Phong-Phan-24404/FPGA.ECG_SYSTEM/README.md

# ECG 1D-CNN Accelerator | KV260 Engineering Deliverables

**Scope:** Synthesizable streaming ECG classifier, bit-true reference models, design verification, routed FPGA implementation, and KV260 host integration.

| Design item | Released configuration |
| :--- | :--- |
| Device / tool | Kria KV260 (`xck26-sfvc784-2LV-c`) / Vivado 2024.2 |
| Custom IP | `xilinx.com:user:CNN_wrapper:3.0` |
| Datapath | 187 input samples → six Conv1D layers → three FC layers → five logits |
| Numeric format | Q8.8 ; Q2.14; 40-bit Q18.22 accumulator |
| Control / data | AXI4-Lite / AXI4-Stream; PS DDR via AXI DMA |
| Clocking | Single 100 MHz PL clock domain |

## Demo
  
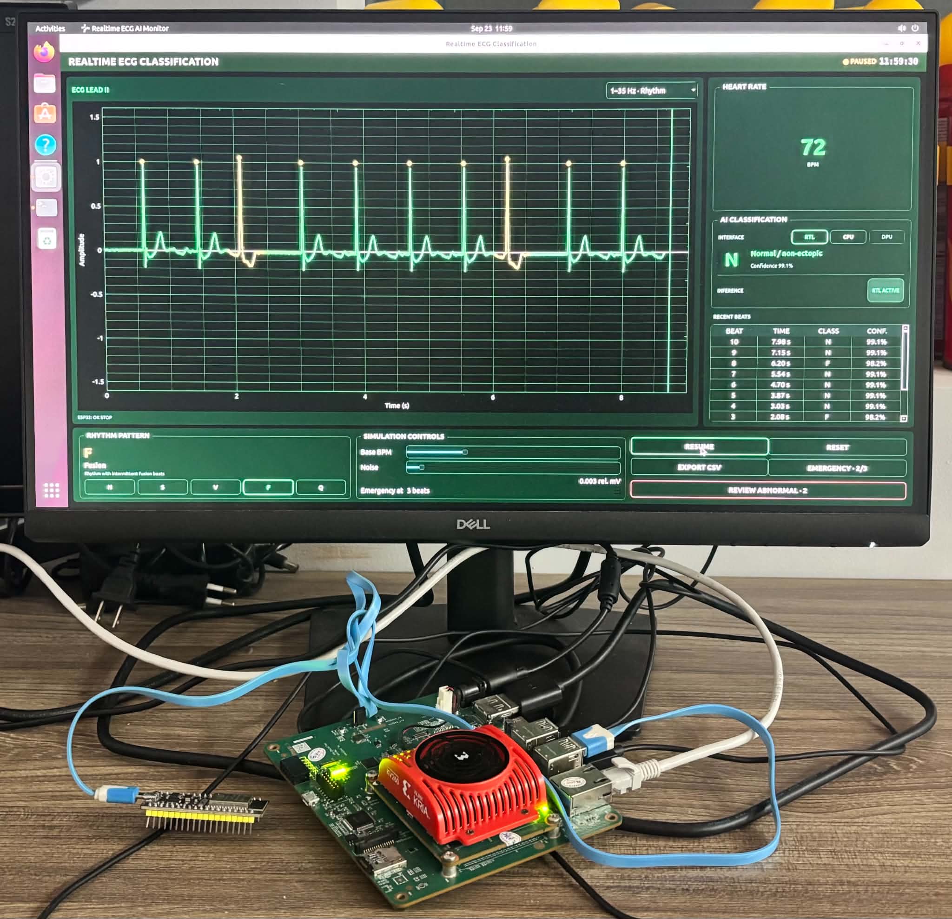
[picture p1: 01_docs/figure/demo_setup.jpg]
demo_setup


## Deliverable index

| Directory | Engineering discipline | Deliverable |
| :--- | :--- | :--- |
| [`01_docs/`](01_docs/) | Specification | Architecture, design specification, verification plan, implementation assessment, issues |
| [`02_model/`](02_model/) | Numerical design | FP32, bit-true fixed-point and hardware-aligned references |
| [`03_rtl/`](03_rtl/) | RTL design engineering | Packaged IP, SystemVerilog source, weight ROMs, build-stage script |
| [`04_verification/`](04_verification/) | Design verification engineering | Benches, regression, netlist replay, vectors, retained evidence |
| [`05_fpga/`](05_fpga/) | FPGA engineering | PS–PL block design, P&R reports, timing study, deployment files |
| [`06_software/`](06_software/) | Embedded integration | DMA host and Qt ECG application |

## Recorded acceptance evidence

| Verification objective | Retained result | Evidence |
| :--- | :--- | :--- |
| RTL functional regression | 26/26 PASS | [`RESULTS.md`](04_verification/03_automated_regression/RESULTS.md) |
| Independent bank-to-scalar mapping | 224,256 weights matched | [`verify_weights.py`](04_verification/03_automated_regression/verify_weights.py) |
| Routed timing | WNS +1.733 ns; WHS +0.012 ns | [`post-route headline`](05_fpga/02_synthesis_implementation_results/02_post_route_implementation/00_headline.txt) |
| FPGA area | 23,987 LUT; 39,800 FF; 130/144 BRAM; 169 DSP | [`utilization report`](05_fpga/02_synthesis_implementation_results/02_post_route_implementation/utilization.rpt) |
| Board arithmetic | 5/5 beats; 25/25 logits bit-exact | [`silicon evidence`](04_verification/06_verification_evidence/03_board_silicon_results/board_golden_check_v3.txt) |
| Board classification | 21,892 beats; 98.16% accuracy; 0.8902 macro-F1 | [`full-set evidence`](04_verification/06_verification_evidence/03_board_silicon_results/board_fullset_v3.txt) |
| Board latency | 1.041 ms/beat (reported mean) | [`full-set evidence`](04_verification/06_verification_evidence/03_board_silicon_results/board_fullset_v3.txt) |

**Evidence boundary:** Timing and board results are retained build measurements, not independently regenerated by this package. The RTL and ROM-mapping checks can be reproduced with the provided scripts and supported tools.

## Verification entry points

From the repository root, with Python 3 and Icarus Verilog (`iverilog`, `vvp`):

```bash
python3 04_verification/03_automated_regression/run_regression.py --suite smoke
python3 04_verification/03_automated_regression/run_regression.py --suite core
python3 04_verification/03_automated_regression/verify_weights.py
```

**Release constraints:** Keep `shreg_extract="no"` on `conv1d_parallel_stream.window_buf`; ensure all 52 runtime ROM images are staged; re-check `CNN_wrapper` SRL usage and post-route hold timing after RTL or implementation changes.

**Outstanding:** Automated netlist SRL check, formal/coverage closure, and source-to-Vivado project regeneration are not demonstrated. Some model utilities still contain pre-reorganization import/default paths. The full MIT-BIH CSV, historical RTL, and full Vivado project are not included. This is an engineering demonstrator, not a validated medical diagnostic device.

**Specifications:** [RTL](01_docs/02_rtl_microarchitecture.md) · [verification](01_docs/03_verification_strategy.md) · [FPGA](01_docs/04_fpga_implementation.md) · [measured results and limitations](01_docs/05_results_and_known_issues.md).
