Phong-Phan-24404/FPGA.ECG_SYSTEM/03_rtl/01_CNN_accelerator_IP/src/ecg_banked_weight_roms.sv

// Fixed-count 64-bit banked synchronous ROM helpers for Phase-2 packed weights.
// Each bank is an independent memory so Vivado can map width/depth geometry
// directly to BRAM36 (or distributed ROM for explicitly tiny tables).

`timescale 1ns / 1ps

// Icarus Verilog 11.0 does not parse `parameter string` even in -g2012 mode.
// These filename parameters must therefore remain untyped for the authoritative
// simulator while retaining string values in Vivado.
// verilog_lint: waive-start explicit-parameter-storage-type

module ecg_dist_sync_rom #(
    parameter int WIDTH = 64,
    parameter int SIZE = 256,
    parameter FILE = ""
)(
    input  logic                    clk,
    input  logic [$clog2(SIZE)-1:0] addr,
    output logic [WIDTH-1:0]        data
);
    // Icarus 11 warns on the Verible-preferred [SIZE] spelling for $readmemh.
    // verilog_lint: waive unpacked-dimensions-range-ordering
    (* rom_style = "distributed" *) logic [WIDTH-1:0] mem [0:SIZE-1];
    initial begin
        if (FILE != "") begin
            $readmemh(FILE, mem);
        end
    end
    always_ff @(posedge clk) begin
        data <= mem[addr];
    end
endmodule

module ecg_sync_rom_select #(
    parameter int WIDTH = 64,
    parameter int SIZE = 256,
    parameter bit DISTRIBUTED = 0,
    parameter FILE = ""
)(
    input  logic                    clk,
    input  logic [$clog2(SIZE)-1:0] addr,
    output wire  [WIDTH-1:0]        data
);
    generate
        if (DISTRIBUTED) begin : gen_dist
            ecg_dist_sync_rom #(.WIDTH(WIDTH), .SIZE(SIZE), .FILE(FILE)) i_rom (
                .clk(clk), .addr(addr), .data(data)
            );
        end else begin : gen_block
            ecg_rom #(.WIDTH(WIDTH), .SIZE(SIZE), .FILE(FILE)) i_rom (
                .clk(clk), .addr(addr), .data(data)
            );
        end
    endgenerate
endmodule

module ecg_banked_rom_1 #(
    parameter int SIZE = 256,
    parameter bit DISTRIBUTED = 0,
    parameter FILE0 = ""
)(
    input  logic                    clk,
    input  logic [$clog2(SIZE)-1:0] addr,
    output wire  [63:0]       data
);
    ecg_sync_rom_select #(
        .WIDTH(64), .SIZE(SIZE), .DISTRIBUTED(DISTRIBUTED),
        .FILE(FILE0)
    ) i_bank0 (
        .clk(clk), .addr(addr), .data(data[63:0])
    );
endmodule

module ecg_banked_rom_2 #(
    parameter int SIZE = 256,
    parameter bit DISTRIBUTED = 0,
    parameter FILE0 = "",
    parameter FILE1 = ""
)(
    input  logic                    clk,
    input  logic [$clog2(SIZE)-1:0] addr,
    output wire  [127:0]       data
);
    ecg_sync_rom_select #(
        .WIDTH(64), .SIZE(SIZE), .DISTRIBUTED(DISTRIBUTED),
        .FILE(FILE0)
    ) i_bank0 (
        .clk(clk), .addr(addr), .data(data[63:0])
    );
    ecg_sync_rom_select #(
        .WIDTH(64), .SIZE(SIZE), .DISTRIBUTED(DISTRIBUTED),
        .FILE(FILE1)
    ) i_bank1 (
        .clk(clk), .addr(addr), .data(data[127:64])
    );
endmodule

module ecg_banked_rom_4 #(
    parameter int SIZE = 256,
    parameter bit DISTRIBUTED = 0,
    parameter FILE0 = "",
    parameter FILE1 = "",
    parameter FILE2 = "",
    parameter FILE3 = ""
)(
    input  logic                    clk,
    input  logic [$clog2(SIZE)-1:0] addr,
    output wire  [255:0]       data
);
    ecg_sync_rom_select #(
        .WIDTH(64), .SIZE(SIZE), .DISTRIBUTED(DISTRIBUTED),
        .FILE(FILE0)
    ) i_bank0 (
        .clk(clk), .addr(addr), .data(data[63:0])
    );
    ecg_sync_rom_select #(
        .WIDTH(64), .SIZE(SIZE), .DISTRIBUTED(DISTRIBUTED),
        .FILE(FILE1)
    ) i_bank1 (
        .clk(clk), .addr(addr), .data(data[127:64])
    );
    ecg_sync_rom_select #(
        .WIDTH(64), .SIZE(SIZE), .DISTRIBUTED(DISTRIBUTED),
        .FILE(FILE2)
    ) i_bank2 (
        .clk(clk), .addr(addr), .data(data[191:128])
    );
    ecg_sync_rom_select #(
        .WIDTH(64), .SIZE(SIZE), .DISTRIBUTED(DISTRIBUTED),
        .FILE(FILE3)
    ) i_bank3 (
        .clk(clk), .addr(addr), .data(data[255:192])
    );
endmodule

// This intentionally shares the fixed-count bank-helper source file.
// verilog_lint: waive module-filename
module ecg_banked_rom_24 #(
    parameter int SIZE = 256,
    parameter bit DISTRIBUTED = 0,
    parameter FILE0 = "",
    parameter FILE1 = "",
    parameter FILE2 = "",
    parameter FILE3 = "",
    parameter FILE4 = "",
    parameter FILE5 = "",
    parameter FILE6 = "",
    parameter FILE7 = "",
    parameter FILE8 = "",
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
    ) i_bank19 (
        .clk(clk), .addr(addr), .data(data[1279:1216])
    );
    ecg_sync_rom_select #(
        .WIDTH(64), .SIZE(SIZE), .DISTRIBUTED(DISTRIBUTED),
        .FILE(FILE20)
    ) i_bank20 (
        .clk(clk), .addr(addr), .data(data[1343:1280])
    );
    ecg_sync_rom_select #(
        .WIDTH(64), .SIZE(SIZE), .DISTRIBUTED(DISTRIBUTED),
        .FILE(FILE21)
    ) i_bank21 (
        .clk(clk), .addr(addr), .data(data[1407:1344])
    );
    ecg_sync_rom_select #(
        .WIDTH(64), .SIZE(SIZE), .DISTRIBUTED(DISTRIBUTED),
        .FILE(FILE22)
    ) i_bank22 (
        .clk(clk), .addr(addr), .data(data[1471:1408])
    );
    ecg_sync_rom_select #(
        .WIDTH(64), .SIZE(SIZE), .DISTRIBUTED(DISTRIBUTED),
        .FILE(FILE23)
    ) i_bank23 (
        .clk(clk), .addr(addr), .data(data[1535:1472])
    );
endmodule

// verilog_lint: waive-stop explicit-parameter-storage-type
