Phong-Phan-24404/FPGA.ECG_SYSTEM/06_software/02_Qt_ECG_application/src/display_processor.h

#pragma once

#include <QVector>

class DisplayProcessor
{
public:
    DisplayProcessor();
    void reset();
    QVector<double> process(const QVector<double> &input);

private:
    struct SosState
    {
        double z1 = 0.0;
        double z2 = 0.0;
    };
    SosState state_[2];
};
