Phong-Phan-24404/FPGA.ECG_SYSTEM/(commit log)

2026-10-15 Initial structured ECG engineering portfolio system
    [path_mapping.csv]
2026-10-16 Update 01_docs: replace old docs with new content
    [path_mapping.csv]
